funkyluke/vtg-ctrl/docs/HSS.md

# High-Side Switch (HSS)

> Stub — to be written.

## Role

*What the high-side switches drive, current/voltage requirements.*

## Key Decisions

- *(pending)*

## Files

- `HSS.SchDoc`

## Backlinks

- [Documentation Hub](Main.md)
