funkyluke/vtg-ctrl/docs/DTM13.md

# DTM13

> Stub — to be written.

## Role

*What the DTM13 block does and how it connects.*

## Key Decisions

- *(pending)*

## Files

- `DTM13.SchDoc`

## Backlinks

- [Documentation Hub](Main.md)
