funkyluke/vtg-ctrl/docs/Thermocouple.md

# Thermocouple Interface (MAX31856)

> Stub — to be written.

## Role

*Cold-junction-compensated thermocouple acquisition via MAX31856.*

## Key Decisions

- *(pending)*

## Files

- `Max31856.SchDoc`

## Backlinks

- [Documentation Hub](Main.md)
