funkyluke/vtg-ctrl/LPF.asc

AC1: voltage; SINE(3 1); AC 1
C1: cap; 10n
C2: cap; 22n
C3: cap; 22n
R1: res; 47k
R2: res; 47k
R3: res; 10k
U1: AD8552
V2: voltage; 5
Named nets: 0, 5V, vout, vin, VRC
.ac dec 020 10 10000000
