funkyluke/vtg-ctrl/(list of files, drawings)

Other design files:
ADC.SchDoc
DRV8874.SchDoc
DTM13.SchDoc
EFuse_5V.SchDoc
EFuse_12V.SchDoc
HSS.SchDoc
Input Protection.SchDoc
LPF.SchDoc
Max31856.SchDoc
MCU.SchDoc
PSU_5V.SchDoc
Turbospeed.SchDoc
VTG-Ctrl.PcbDoc
VTG-Ctrl.PrjPcb
VTG-Ctrl.SchDoc
VTG-Ctrl_Overview.SchDoc
