funkyluke/vtg-ctrl/(commit log)

2025-10-26 Project VTG-Ctrl was created from the template.
    [AFR_Template.PcbDoc, AFR_Template_Main.SchDoc, AFR_Template_Overview.SchDoc, VTG-Ctrl.PrjPcb]
2026-09-19 Add active-filter (250 Hz LPF, TLV9001) decision to ADC docs
2026-09-20 Add agent coordination contract, ADC LPF decision (DDD-001), and LTspice scratch ignores
2026-09-24 Document measured effective input impedance of ADC LPF
2026-09-25 Add turbo-speed input docs (Jaquet sensor, 250k RPM max, 375 Hz-3.125 kHz output range)
2026-09-25 Document Stamp-S3A strapping and special GPIO pins in MCU docs
2026-09-25 Decide PESD5V0S2BT connector TVS for all 5V I/Os; refine turbo-speed conditioning (DDD-002)
2026-09-27 Add AGENTS rules: Altium files read-only unless asked, skip autogenerated history dirs; add DDD-003 DRV8874 VTG-actuator decision
2026-10-04 Motor driver: DDD-004 current limit via MCP4725-driven VREF, RIPROPI 1.2k, IMODE fixed off-time, ITRIP above stall; supersede DDD-003; fill Motor-Driver.md
2026-10-04 Power protection: DDD-005 central 12V input protection concept (load-dump TVS, reverse polarity, DRV8874 VM bulk), 24V jump-start notes; Power-Protection.md with automotive 12V ECU requirements (ISO 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
